xdylanm/vca-module/README.md

# Dual VCA

A dual VCA module based on the LM13700 OTA in a Eurorack format.
