xdylanm/vca-module/docs/assets/images/gain_vs_CV_2025-06-19.png

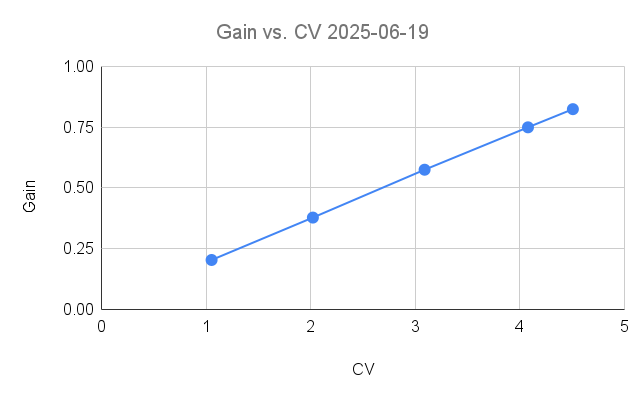
docs/assets/images/gain_vs_CV_2025-06-19.png
