xdylanm/vca-module/docs/assets/bom.md

| Reference | Value | Qty |
| --- | --- | --- |
| C1,C2 | 220p | 2 |
| C3,C4,C5,C7,C8,C9 | 100n | 6 |
| C6,C10 | 10u | 2 |
| D1,D2 | 1N4148 | 2 |
| D3,D4 | 1N5819 | 2 |
| J1,J2,J3,J4,J5,J6 | WQP-PJ323M | 6 |
| J7 | IDC Header 10P | 1 |
| Q1,Q2 | BC557 | 2 |
| R1,R10 | 68k | 2 |
| R2,R11 | 15k | 2 |
| R8,R17 | 56k | 2 |
| R3,R4,R6,R12,R13,R15 | 100k | 6 |
| RV1,RV2 | 3296W 100k | 2 |
| RV3,RV4 | RV09 B100k | 2 |
| R5,R7,R14,R16 | 220R | 4 |
| R9,R18 | 1k | 2 |
| R19,R20 | 10R | 2 |
| U1 | TL074 | 1 |
| U2 | LM13700 | 1 |
