xdylanm/vca-module/docs/assets/schematic.pdf

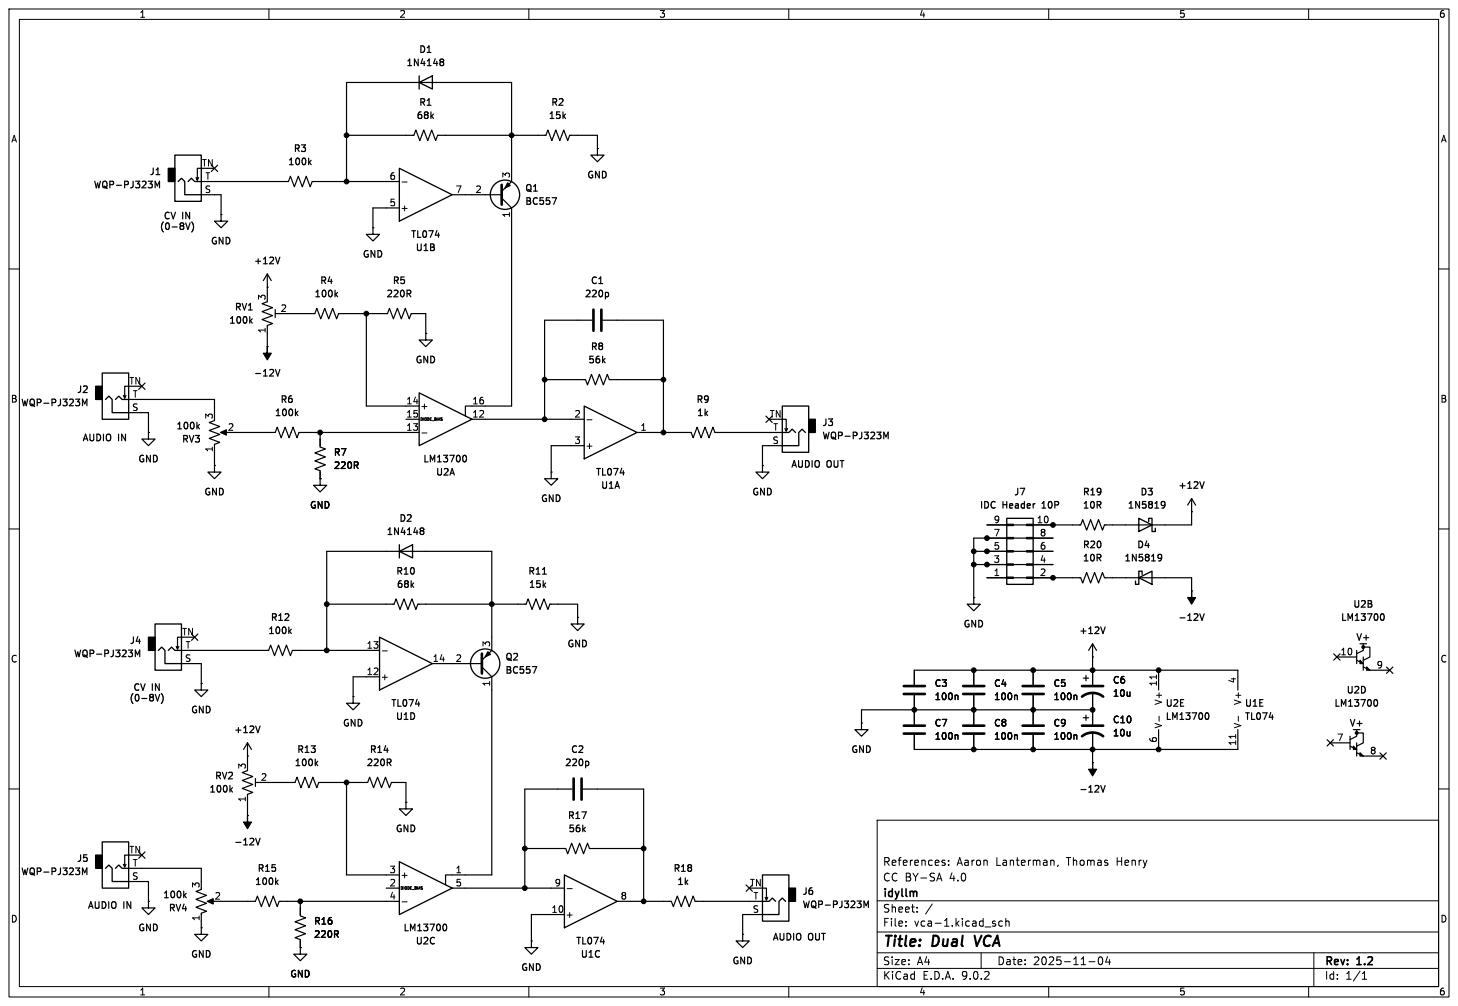
[picture p5: page 1]

AUDIO OUT CV IN

idyllm
File: vca-1.kicad_sch Sheet: /
Id: 1/1 Title: Dual VCA
