xdylanm/vca-module/hardware/vca-1/vca-1.kicad_pcb

## KiCad design hardware/vca-1/vca-1.kicad_pcb (2025-11-05)

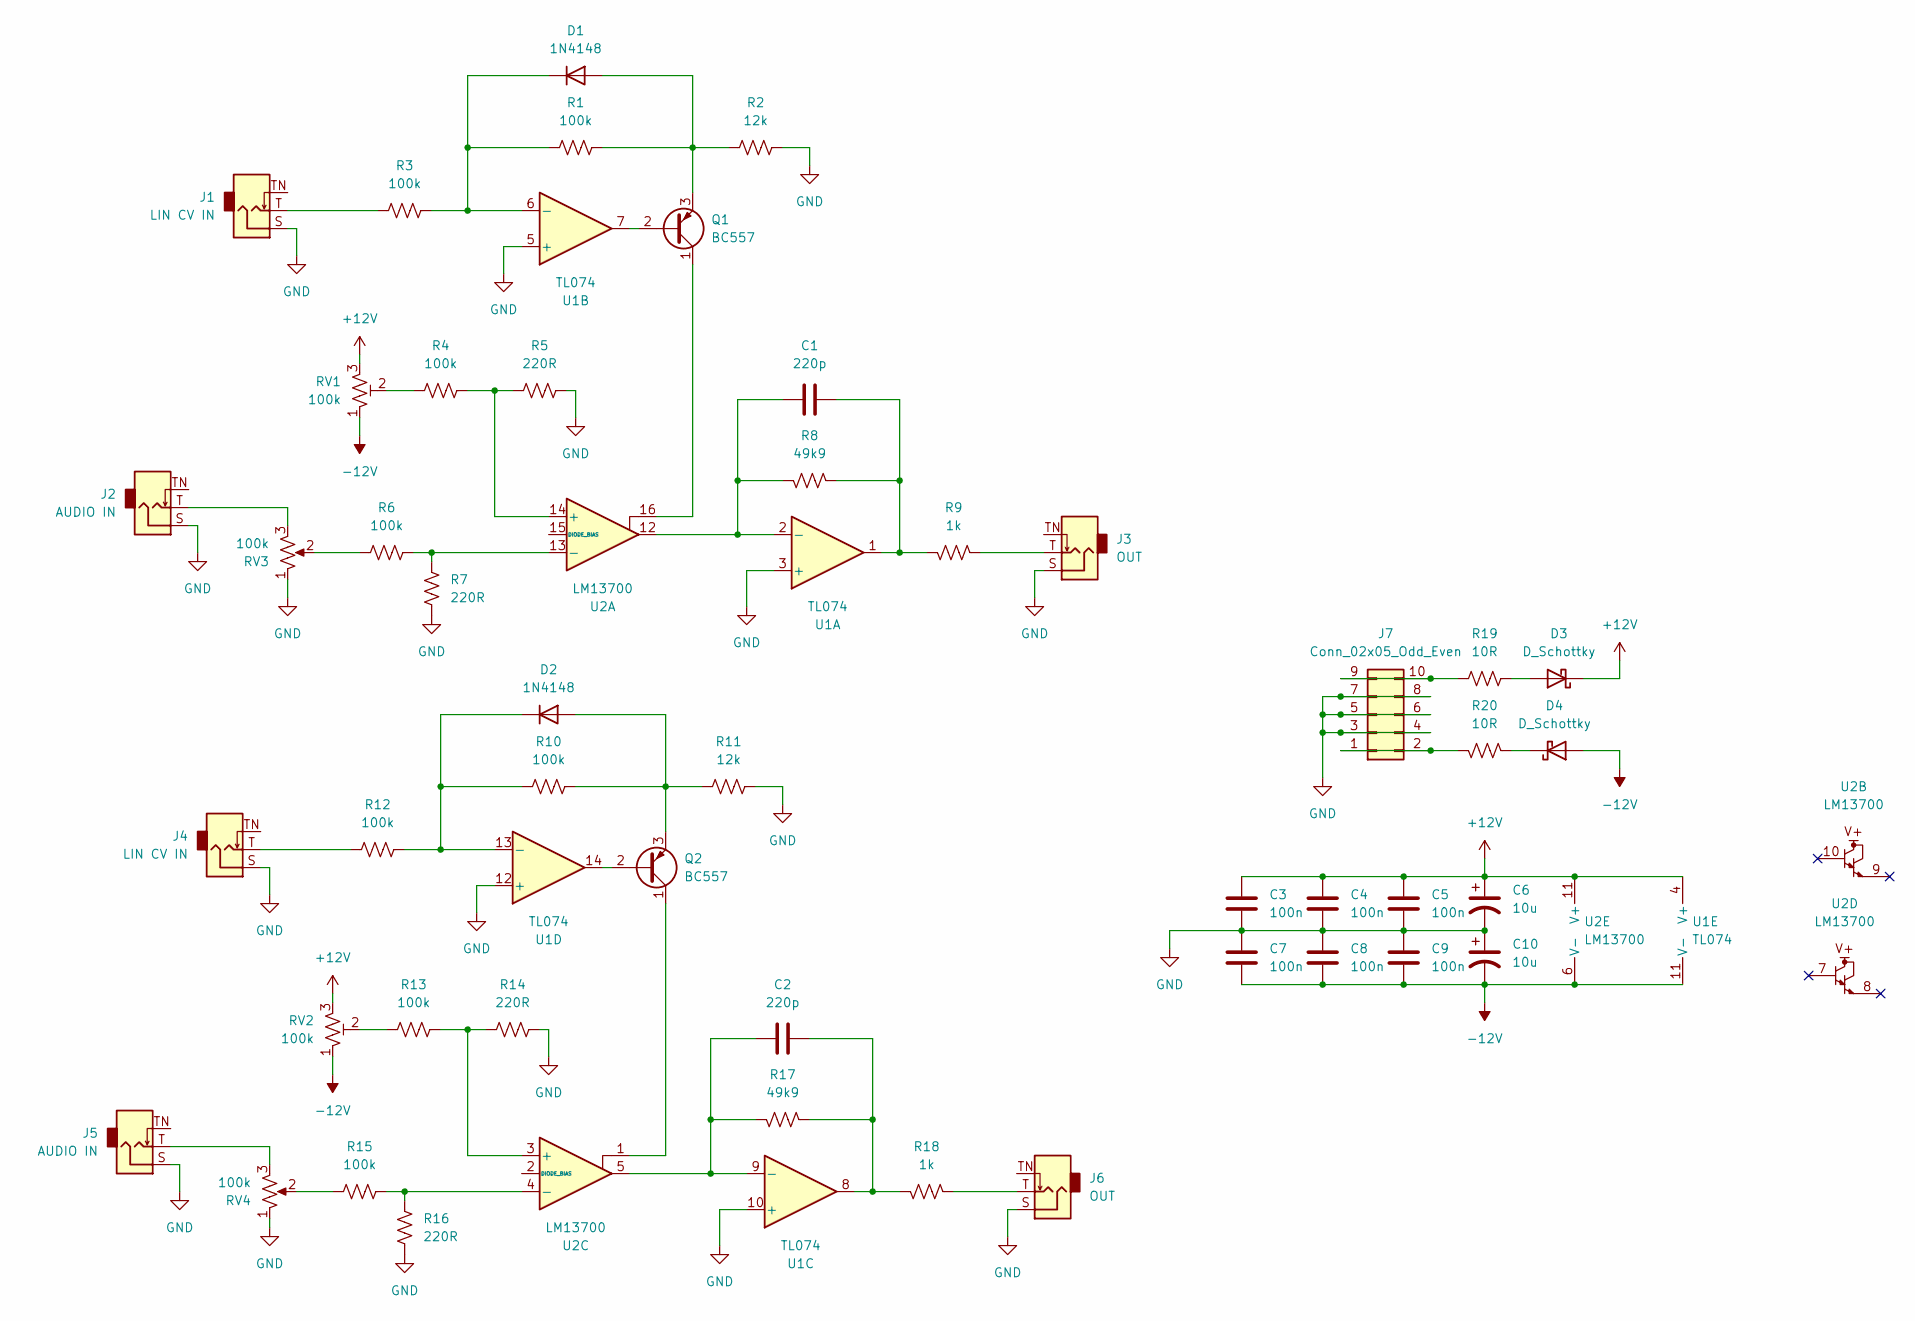
[picture p6: schematic vca-1.kicad_sch, Dual VCA]

Parts:
C1, C2: 220p; C_Disc_D4.3mm_W1.9mm_P5.00mm
C3, C4, C5, C7, C8, C9: 100n; C_Disc_D4.3mm_W1.9mm_P5.00mm
C6, C10: 10u; CP_Radial_D5.0mm_P2.50mm
D1, D2: 1N4148; D_DO-35_SOD27_P7.62mm_Horizontal
D3, D4: D_Schottky; D_DO-41_SOD81_P2.54mm_Vertical_KathodeUp
J1, J4: LIN CV IN; Jack_3.5mm_QingPu_WQP-PJ323M_Horizontal
J2, J5: AUDIO IN; Jack_3.5mm_QingPu_WQP-PJ323M_Horizontal
J3, J6: OUT; Jack_3.5mm_QingPu_WQP-PJ323M_Horizontal
J7: Conn_02x05_Odd_Even; IDC-Header_2x05_P2.54mm_Horizontal
Q1, Q2: BC557; TO-92_Inline_Wide
R1, R4, R10, R13: 100k; R_Axial_DIN0204_L3.6mm_D1.6mm_P2.54mm_Vertical
R2, R11: 12k; R_Axial_DIN0204_L3.6mm_D1.6mm_P2.54mm_Vertical
R3, R6, R12: 100k; R_Axial_DIN0204_L3.6mm_D1.6mm_P7.62mm_Horizontal
R5, R7, R14, R16: 220R; R_Axial_DIN0204_L3.6mm_D1.6mm_P2.54mm_Vertical
R8, R17: 49k9; R_Axial_DIN0204_L3.6mm_D1.6mm_P2.54mm_Vertical
R9, R18: 1k; R_Axial_DIN0204_L3.6mm_D1.6mm_P7.62mm_Horizontal
R15: 100k; R_Axial_DIN0207_L6.3mm_D2.5mm_P10.16mm_Horizontal
R19, R20: 10R; R_Axial_DIN0204_L3.6mm_D1.6mm_P2.54mm_Vertical
RV1, RV2: 100k; Potentiometer_Bourns_3296W_Vertical
RV3, RV4: 100k; Potentiometer_Bourns_PTV09A-2_Single_Horizontal
U1: TL074; DIP-14_W7.62mm_Socket
U2: LM13700; SOIC-16_3.9x9.9mm_P1.27mm

Connections:
+12V: C3.1, C4.1, C5.1, C6.1, D3.1 (K), RV1.3, RV2.3, U1.4 (V+), U2.11 (V+)
-12V: C7.2, C8.2, C9.2, C10.2, D4.2 (A), RV1.1, RV2.1, U1.11 (V-), U2.6 (V-)
GND: C3.2, C4.2, C5.2, C6.2, C7.1, C8.1, C9.1, C10.1, J1.S, J2.S, J3.S, J4.S, J5.S, J6.S, J7.3, J7.4, J7.5, J7.6, J7.7, J7.8, R2.1, R5.1, R7.1, R11.1, R14.1, R16.1, RV3.1, RV4.1, U1.3 (+), U1.5 (+), U1.10 (+), U1.12 (+)
unnamed: C1.2, R8.2, R9.1, U1.1
unnamed: C2.2, R17.2, R18.1, U1.8
unnamed: D1.2 (A), Q1.3 (E), R1.1, R2.2
unnamed: D1.1 (K), R1.2, R3.1, U1.6 (-)
unnamed: D2.2 (A), Q2.3 (E), R10.1, R11.2
unnamed: D2.1 (K), R10.2, R12.1, U1.13 (-)
unnamed: D3.2 (A), R19.2
unnamed: D4.1 (K), R20.2
unnamed: J1.T, R3.2
unnamed: J2.T, RV3.3
unnamed: J3.T, R9.2
unnamed: J4.T, R12.2
unnamed: J5.T, RV4.3
unnamed: J6.T, R18.2
unnamed: J7.1, J7.2, R20.1
unnamed: J7.9, J7.10, R19.1
unnamed: Q1.2 (B), U1.7
unnamed: Q1.1 (C), U2.16
unnamed: Q2.2 (B), U1.14
unnamed: Q2.1 (C), U2.1
unnamed: R4.2, RV1.2
unnamed: R6.2, RV3.2
unnamed: R13.2, RV2.2
unnamed: R15.2, RV4.2
unnamed: C1.1, R8.1, U1.2 (-), U2.12
unnamed: C2.1, R17.1, U1.9 (-), U2.5
unnamed: R4.1, R5.2, U2.14 (+)
unnamed: R6.1, R7.2, U2.13 (-)
unnamed: R13.1, R14.2, U2.3 (+)
unnamed: R15.1, R16.2, U2.4 (-)

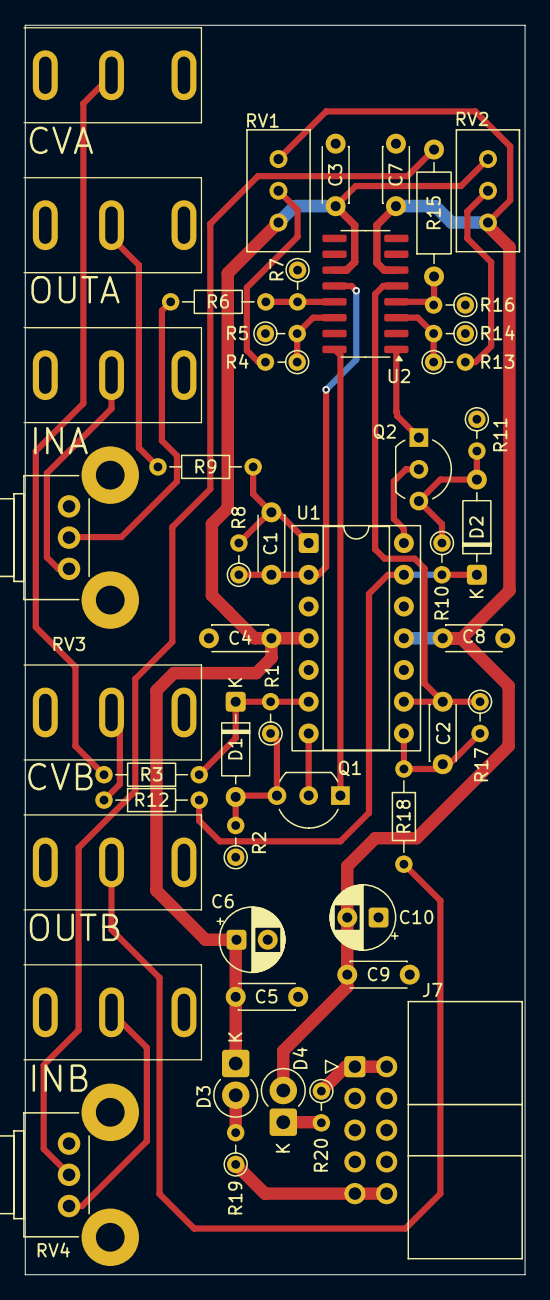
[picture p7: board vca-1.kicad_pcb from above]

Board: 2 copper layers, 40.0 x 100.0 mm, 49 parts (0 on the bottom side), 33 nets.
