xdylanm/vca-module/(commit log)

2025-06-19 First version of linearly controlled dual VCA
    [vca-1.kicad_pcb, vca-1.kicad_sch]
2025-06-20 Added a level pot on the audio inputs, v1.1
    [vca-1.kicad_pcb, vca-1.kicad_sch]
2025-10-31 VCA face plate and doc updates
    [vca-1.kicad_sch, vca1_faceplate.kicad_pcb, vca1_faceplate.kicad_sch]
2025-10-31 sketch for v2 VCA (WIP)
    [vca-2.kicad_pcb, vca-2.kicad_sch]
2025-10-31 Migrated to mkdocs/material
2025-10-31 unity gain at 5V
2025-10-31 Updated component values for unity gain at 8V CV in to match ADSR
    [vca-1.kicad_sch]
2025-11-04 Updated schematic values based on testing. Updated docs with measurements from board.
    [vca-1.kicad_sch]
