xdylanm/vca-module/(notices)

Notices in the files:
hardware/vca-1/vca-1.kicad_sch:
CC BY-SA 4.0
hardware/vca-2/vca-2.kicad_pcb:
idyllm CC BY-SA 4.0
